amperolithic/bolide-65-keeb/assets/readme/bolide-CAD_case.png

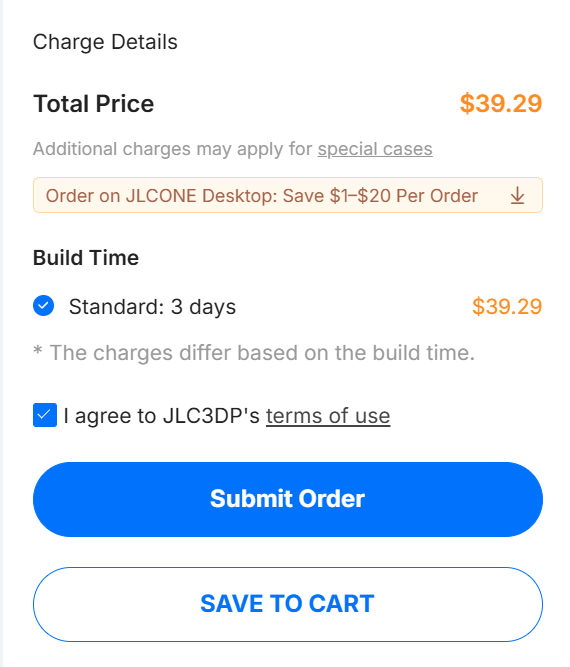
assets/readme/bolide-CAD_case.png
