amperolithic/bolide-65-keeb/assets/readme/bolide-switch_plate.png

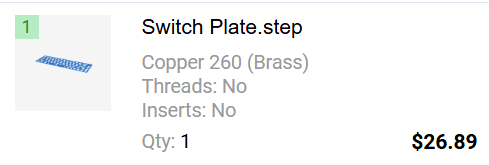
assets/readme/bolide-switch_plate.png
