amperolithic/bolide-65-keeb/production/CAD-Main Body.step

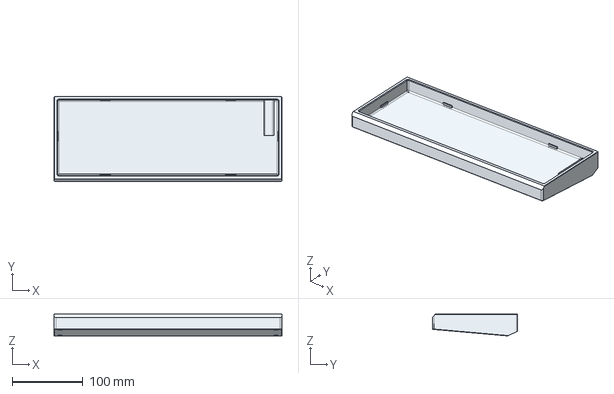
[picture p6: CAD file, 2026-11-13]
production/CAD-Main Body.step
322.6 x 120.6 x 30.9 mm
