amperolithic/bolide-65-keeb/production/CAD-Switch Plate.step

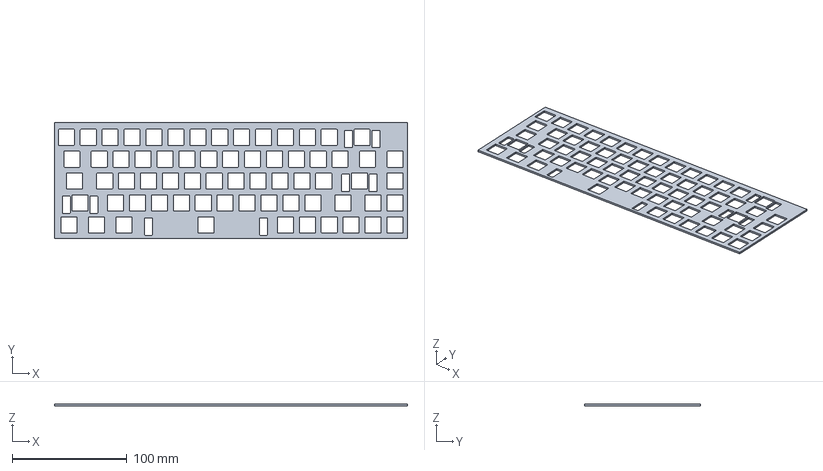
[picture p7: CAD file, 2026-11-13]
production/CAD-Switch Plate.step
307.0 x 101.0 x 1.60 mm
