amperolithic/bolide-65-keeb/(list of files, cad)

Other CAD files:
cad/Keyboard_Assembly.step
